Sfarsads/ecg-analog-frontend-pcb/ECG_FrontEnd.pdf

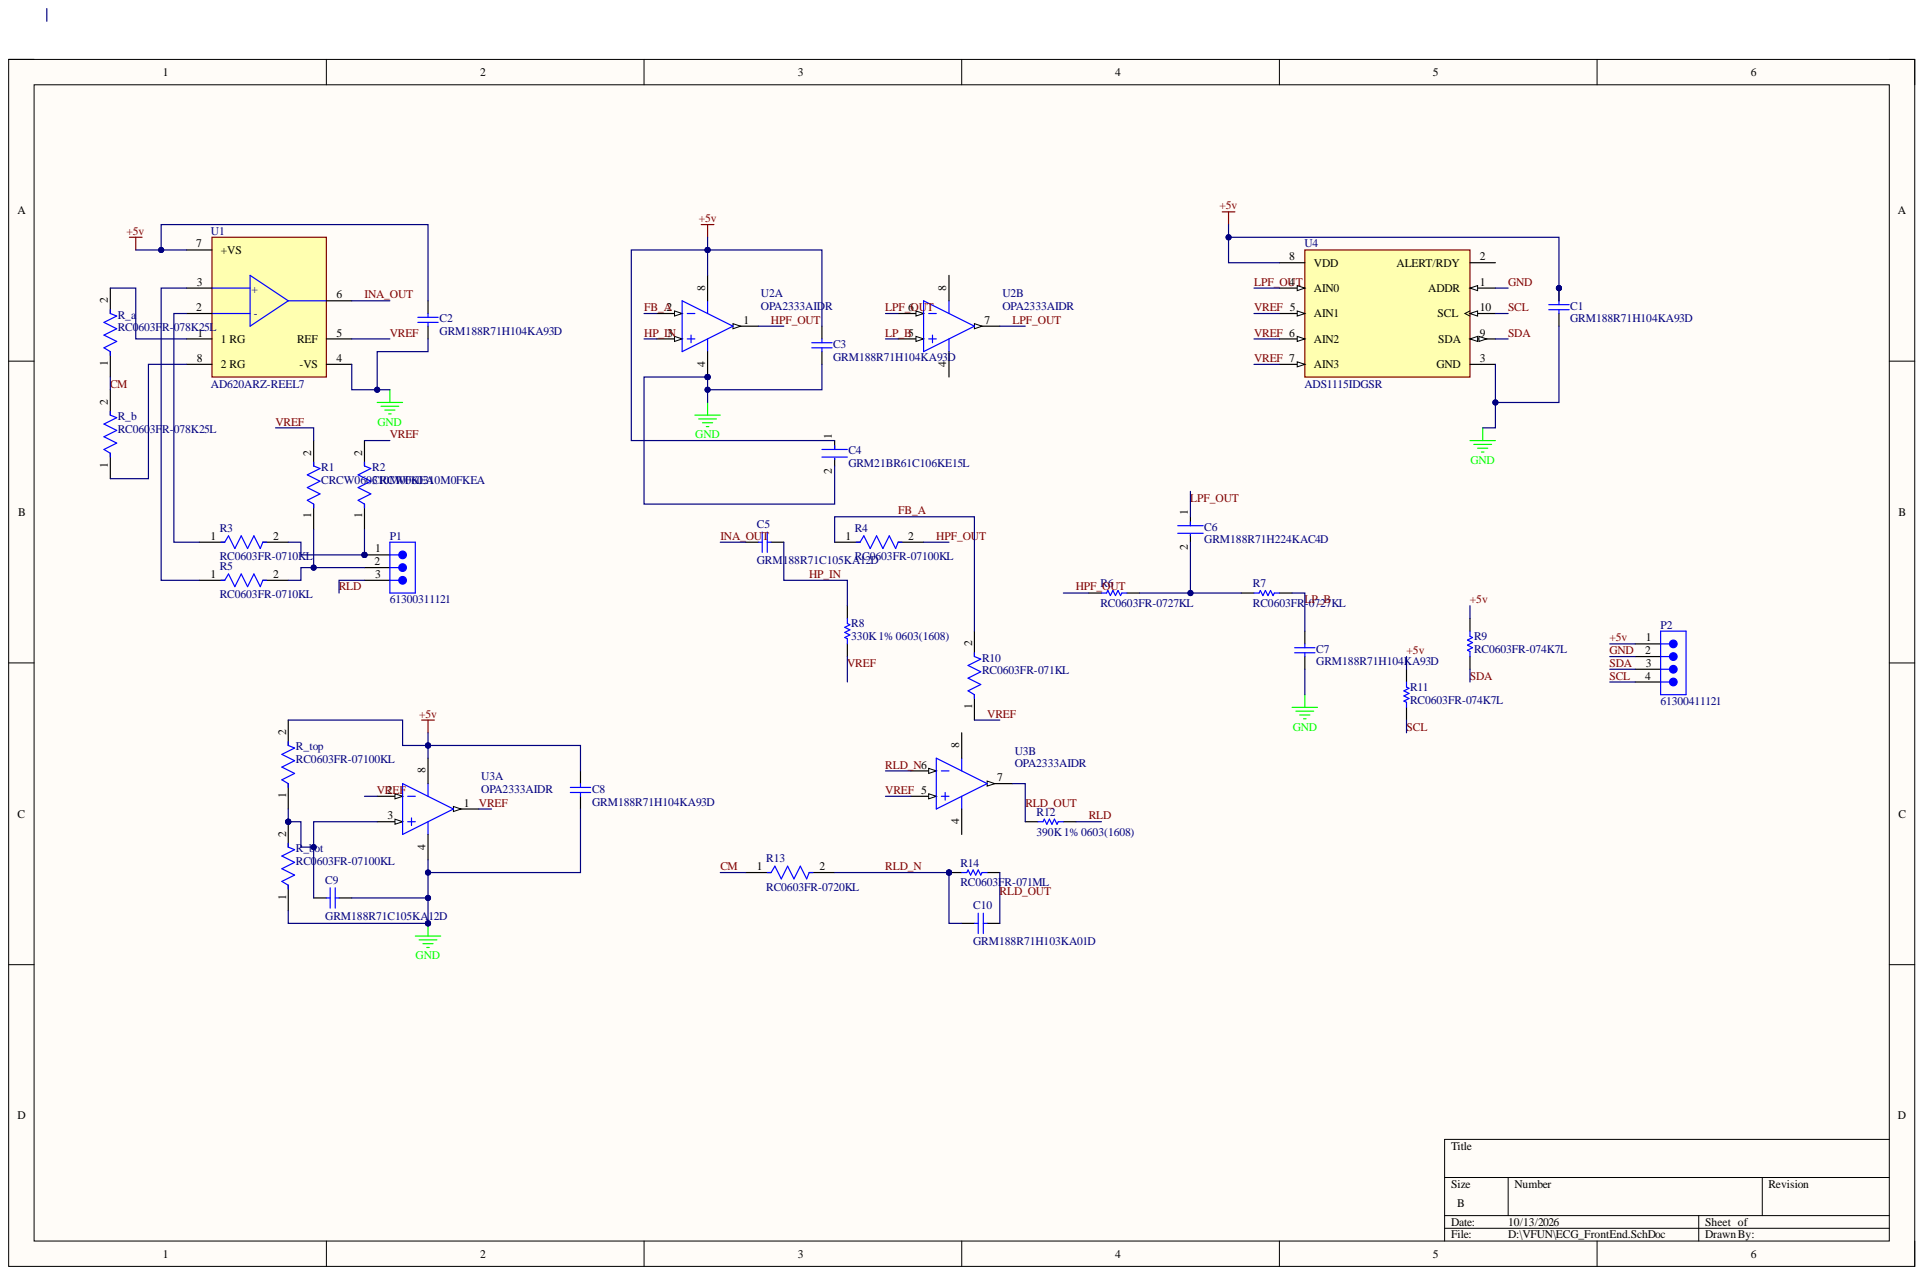
[picture p8: page 1]

LPF_O U 4 T | 1

Si z e | Num b er | Revi s i on

e : 10/13/ 20 2 6 | Sheet of
Fi l e : D : \VFU N\E C G_Front End.Sch Do c | D rawn By:

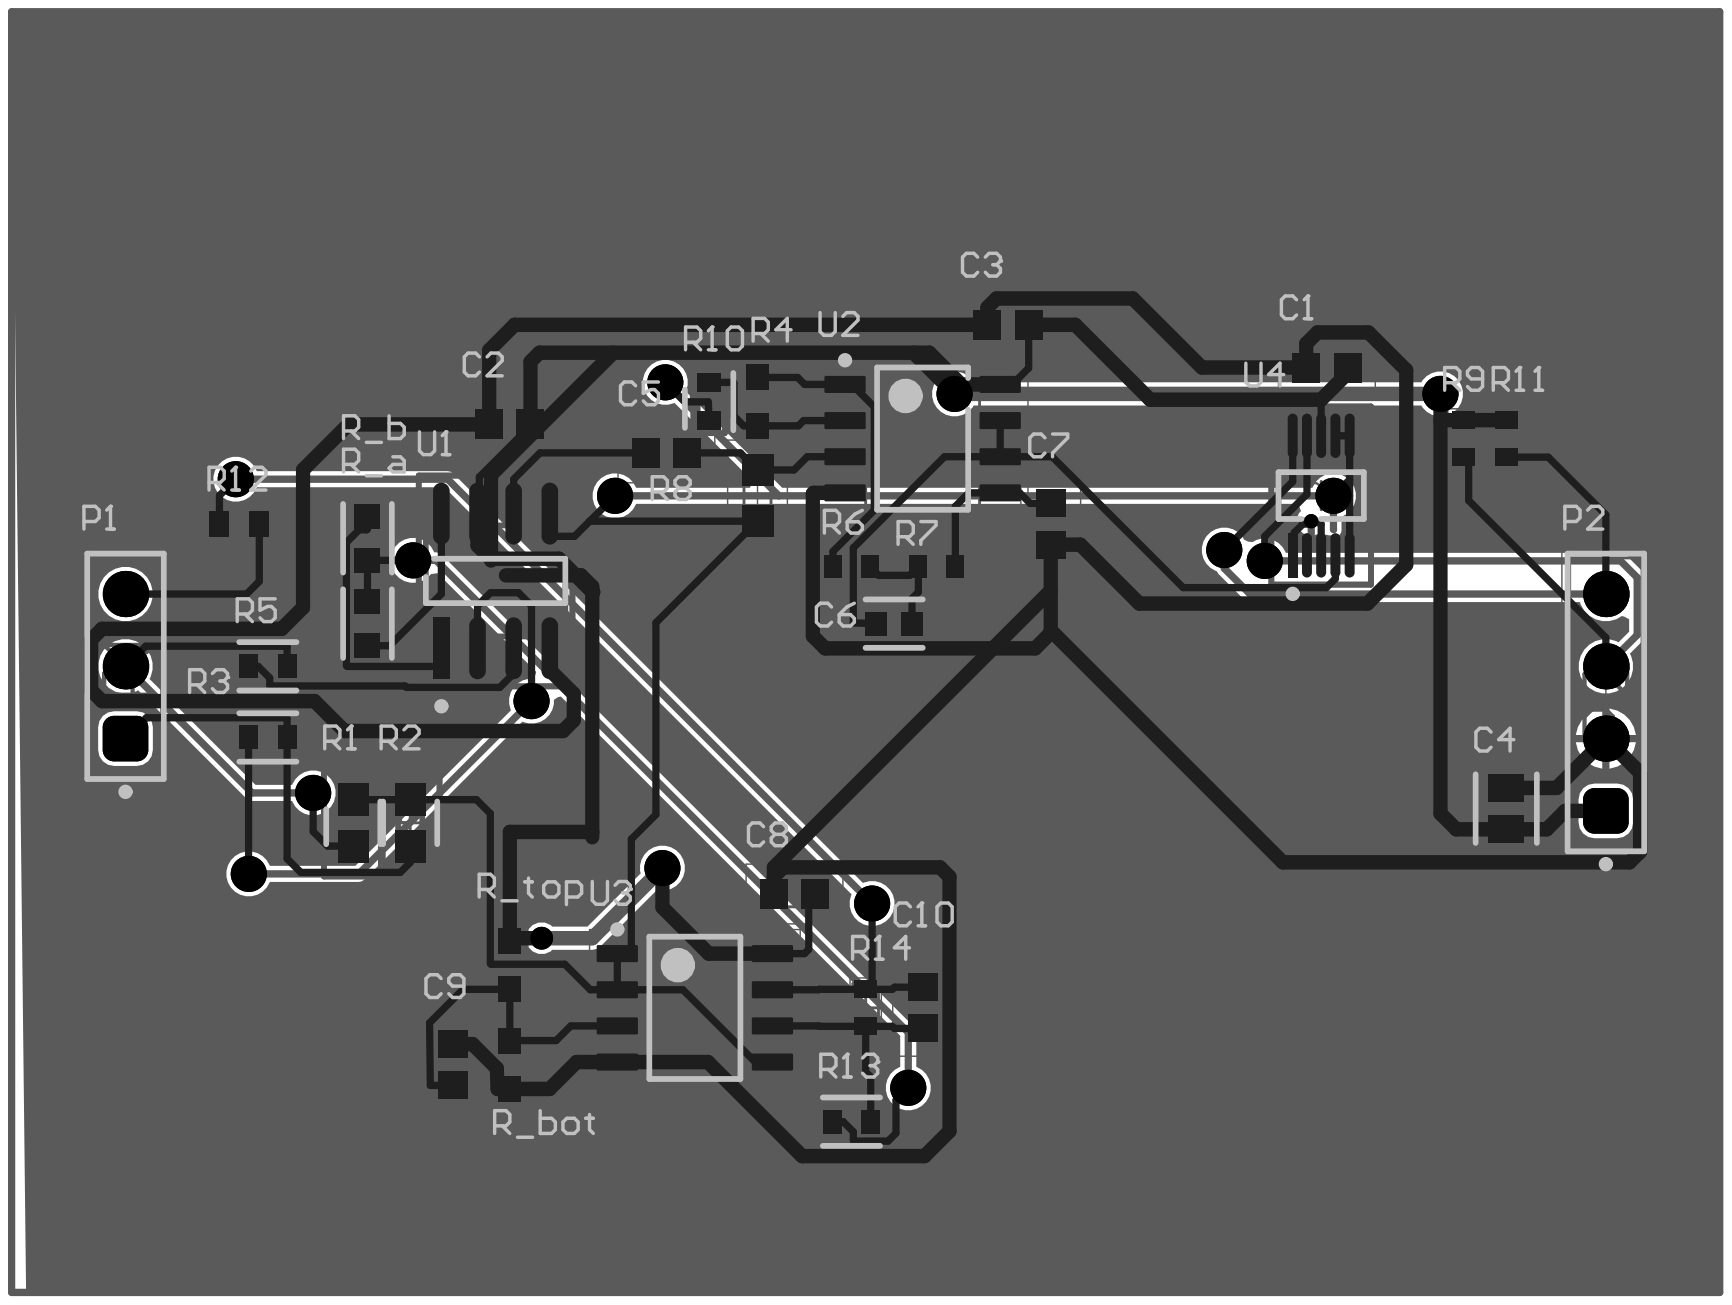
[picture p9: page 2]
