Sfarsads/ecg-analog-frontend-pcb/(list of files, drawings)

Other design files:
ECG_FrontEnd.PcbDoc
ECG_FrontEnd.SchDoc
